jpwright/asp-lfc/README.md

asp-lfc
=======

Schematics and code for my MEng project, a portable light field camera based on angle-sensitive pixel imager.
