jpwright/asp-lfc/MATLAB/poster images/artagain-multi.png

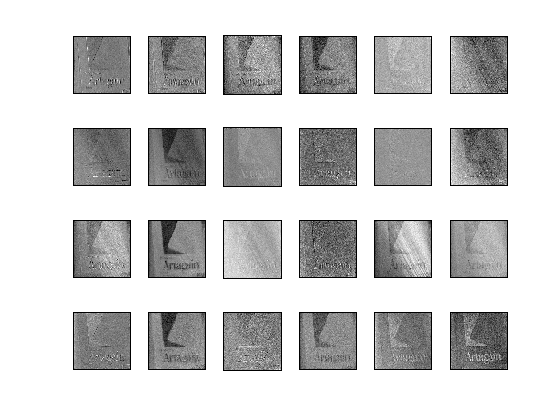
MATLAB/poster images/artagain-multi.png
