jpwright/asp-lfc/MATLAB/poster images/artagain.png

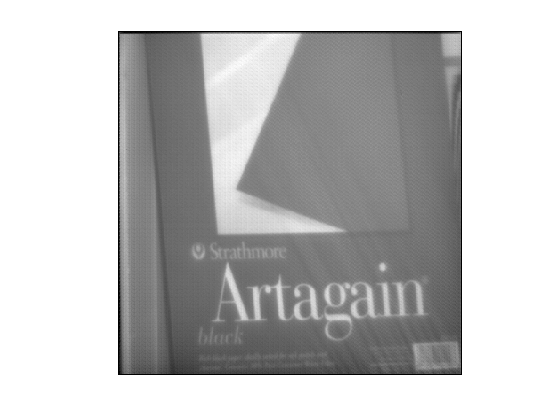
MATLAB/poster images/artagain.png
