jpwright/asp-lfc/MATLAB/poster images/equipment2-multi.png

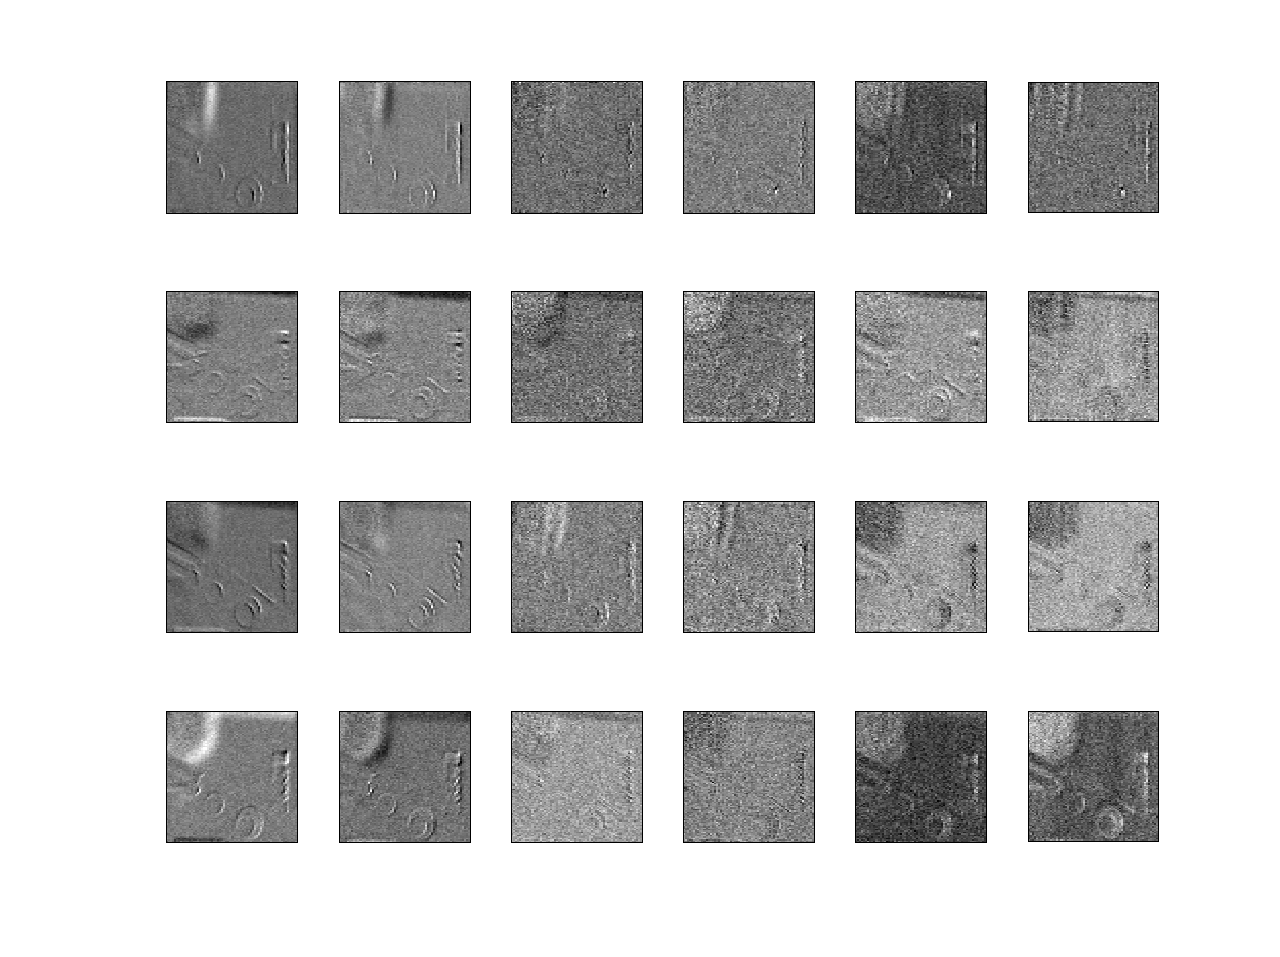
MATLAB/poster images/equipment2-multi.png
