jpwright/asp-lfc/MATLAB/poster images/equipment2.png

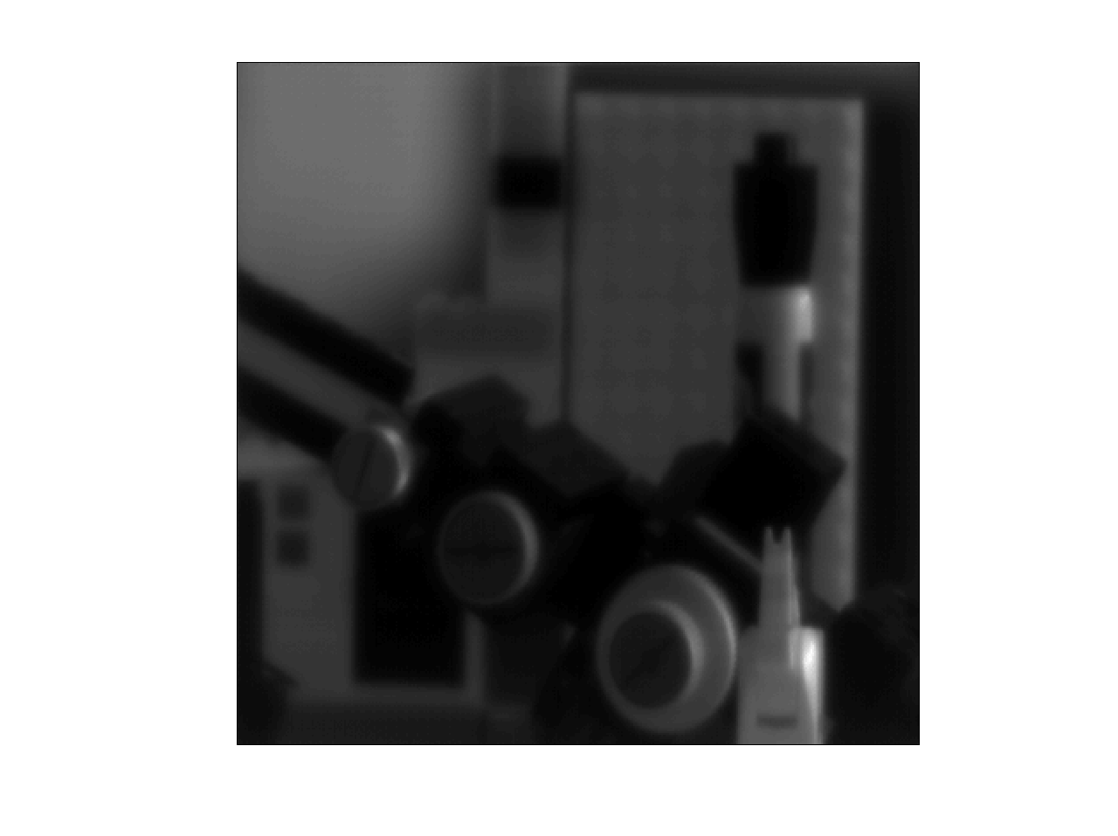
MATLAB/poster images/equipment2.png
