jpwright/asp-lfc/MATLAB/poster images/equipment-multi.png

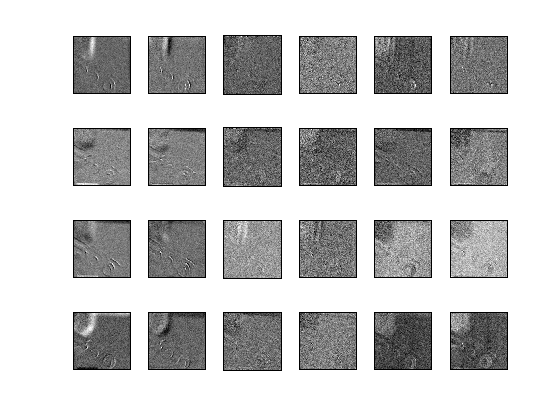
MATLAB/poster images/equipment-multi.png
