jpwright/asp-lfc/MATLAB/poster images/equipment.png

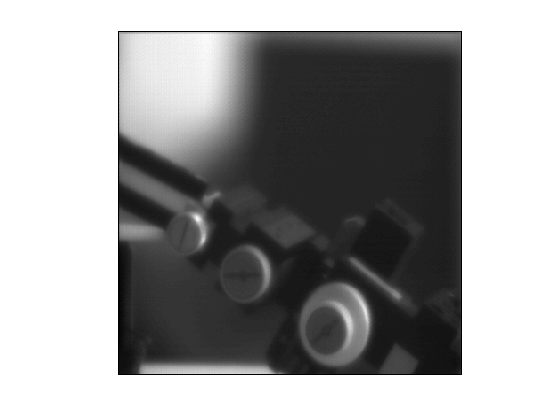
MATLAB/poster images/equipment.png
