jpwright/asp-lfc/MATLAB/poster images/molnar-multi.png

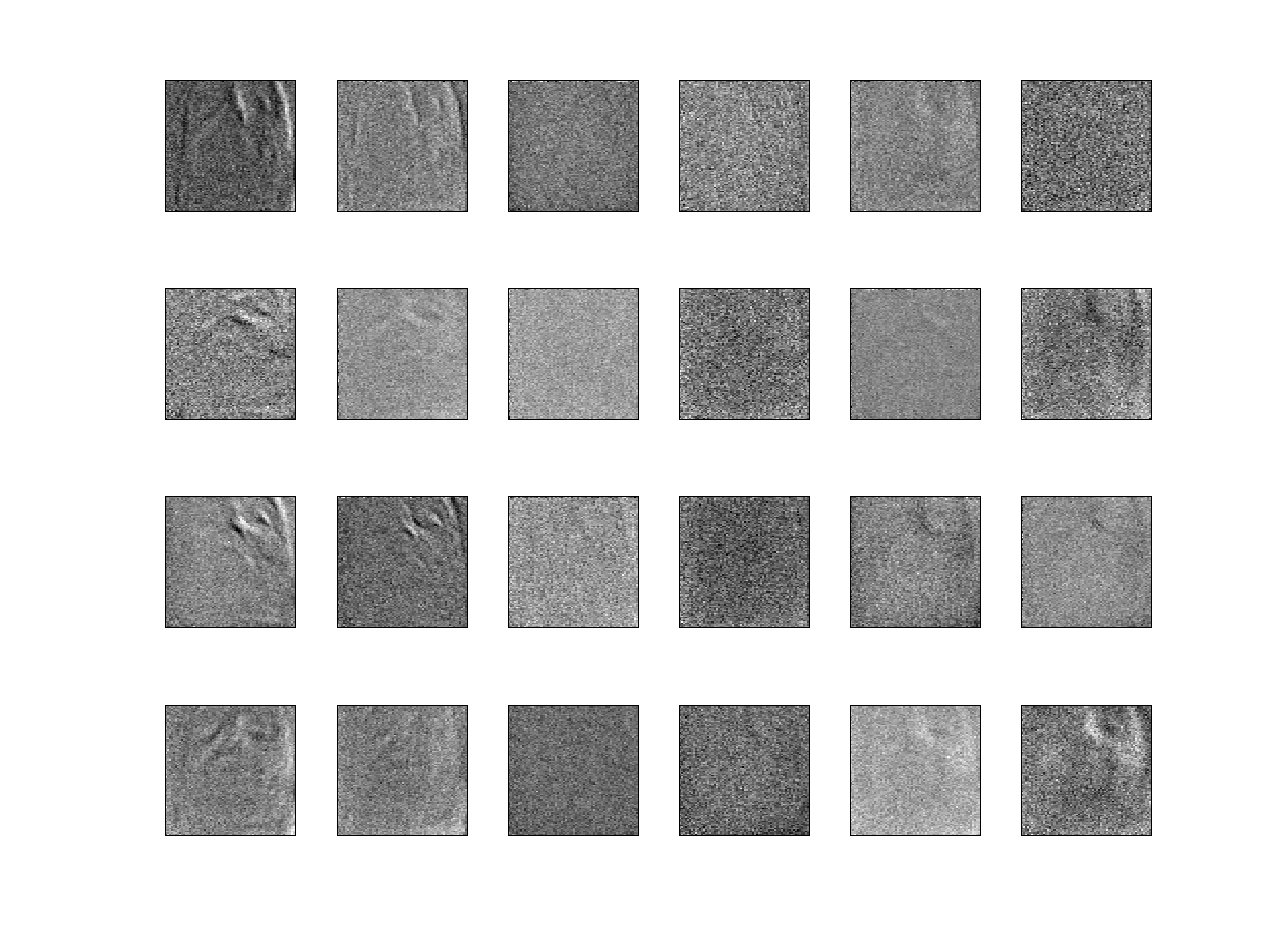
MATLAB/poster images/molnar-multi.png
