jpwright/asp-lfc/MATLAB/poster images/molnar.png

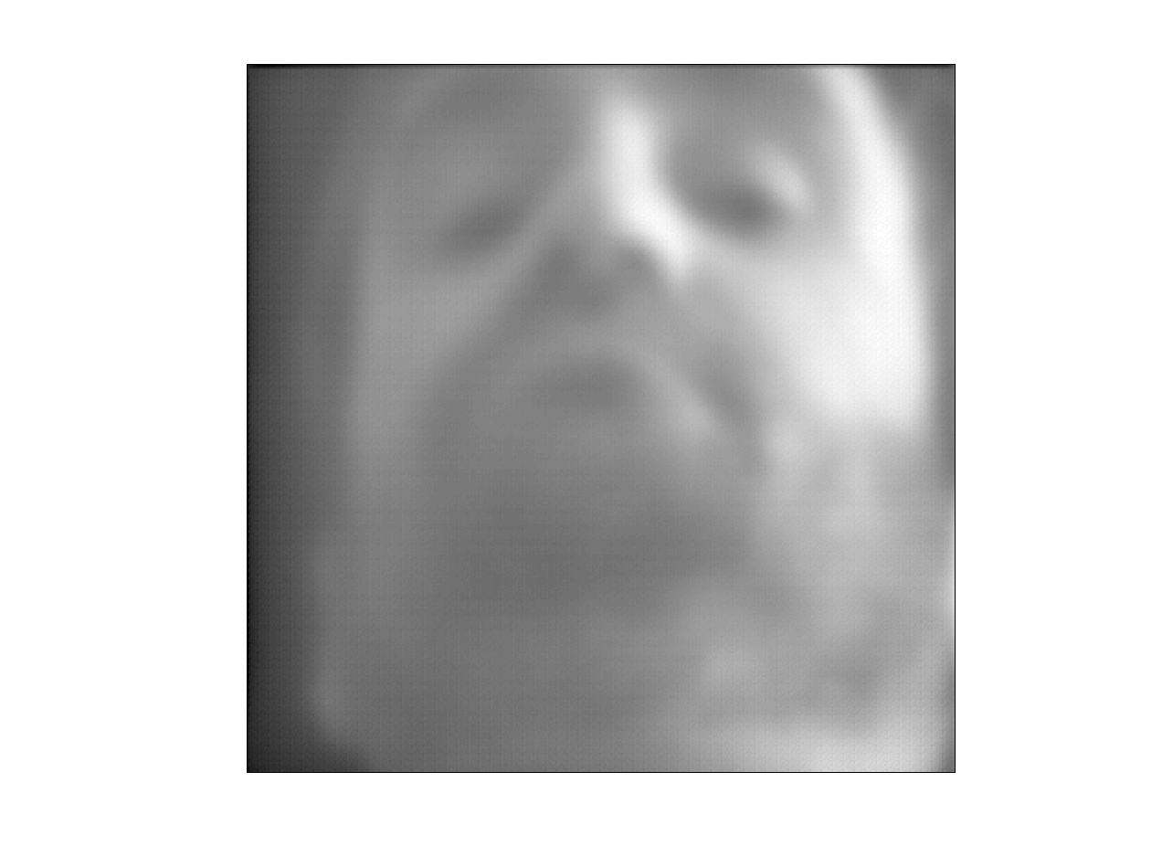
MATLAB/poster images/molnar.png
