jpwright/asp-lfc/PCB/protoCtrl/image-layout.png

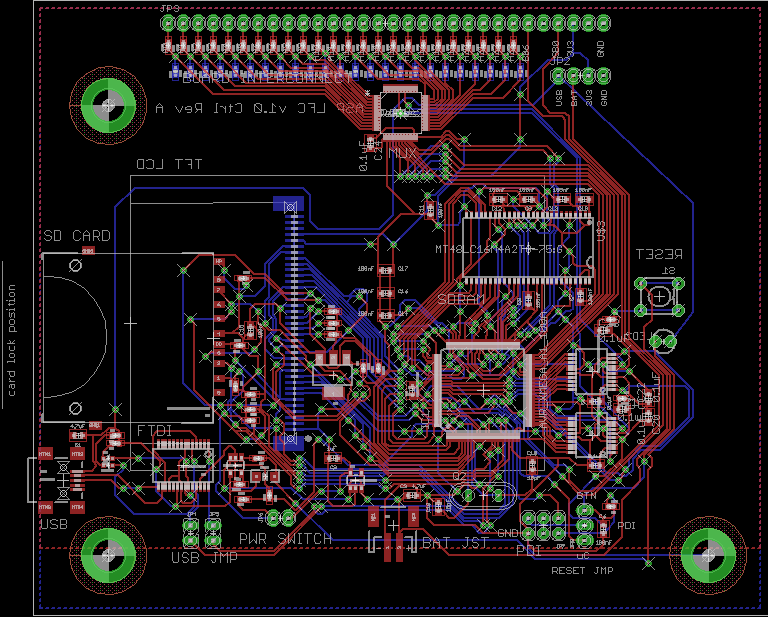
PCB/protoCtrl/image-layout.png
