jpwright/asp-lfc/PCB/protoCtrl/image.png

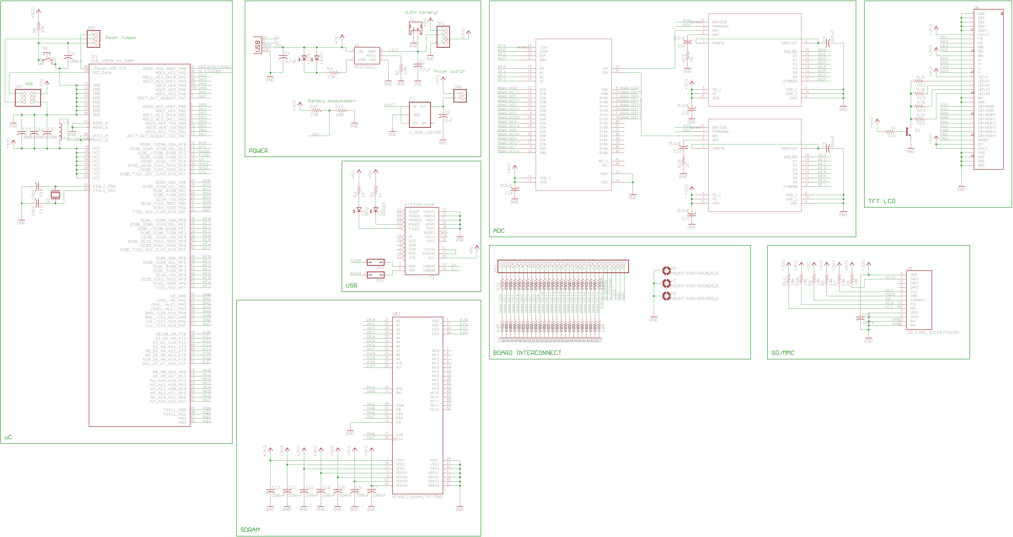
PCB/protoCtrl/image.png
