jpwright/asp-lfc/3D/mount/lensmount2.stl

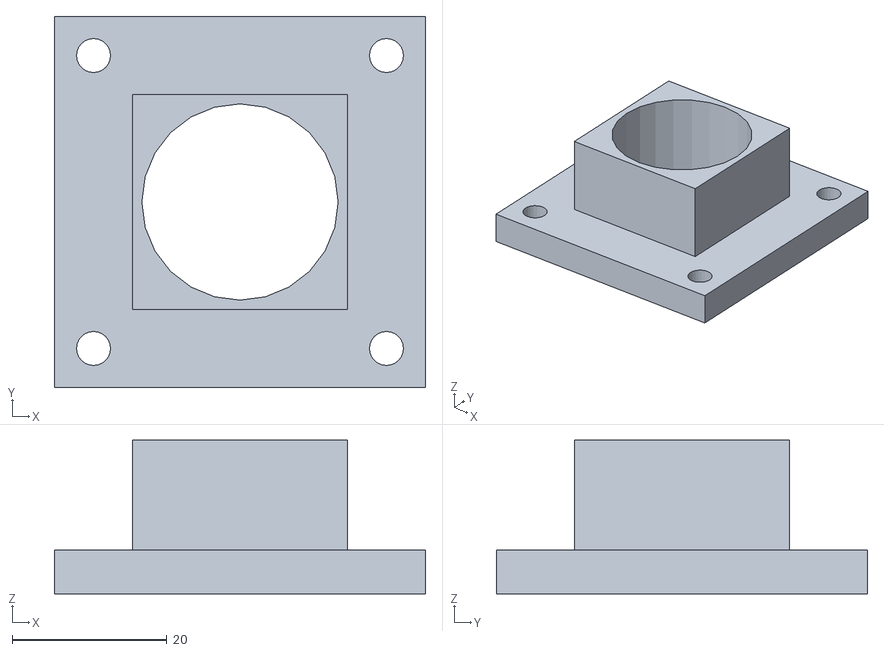
[picture p11: CAD file, 2013-05-15]
3D/mount/lensmount2.stl
48.0 x 48.0 x 19.9
