jpwright/asp-lfc/3D/spacers/v1-outer-dual.stl

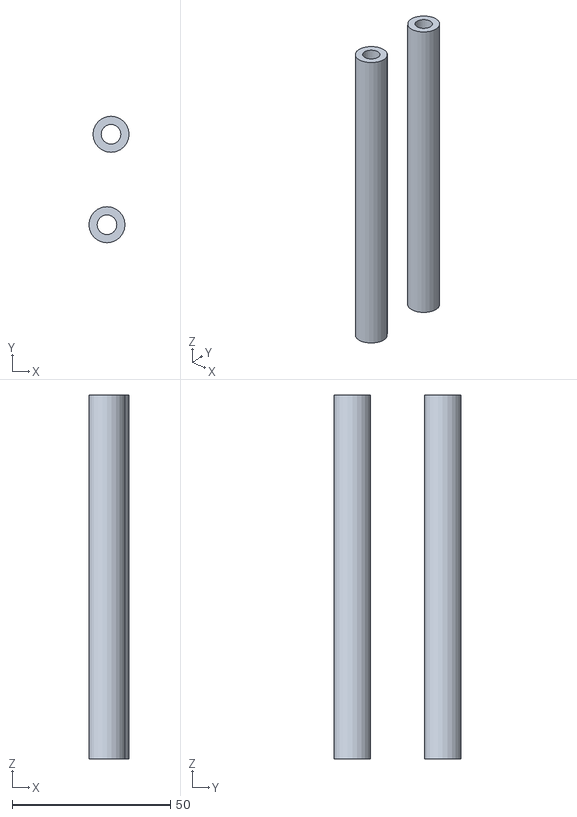
[picture p12: CAD file, 2013-05-15]
3D/spacers/v1-outer-dual.stl
12.7 x 40.0 x 114.9
