jpwright/asp-lfc/3D/mount/lensmount.stl

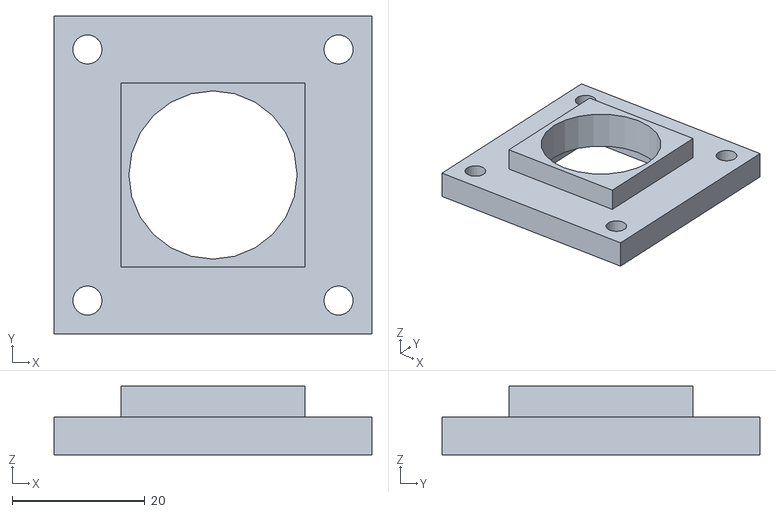
[picture p13: CAD file, 2013-05-15]
3D/mount/lensmount.stl
48.0 x 48.0 x 10.4
