jpwright/asp-lfc/3D/spacers/v1-outer.stl

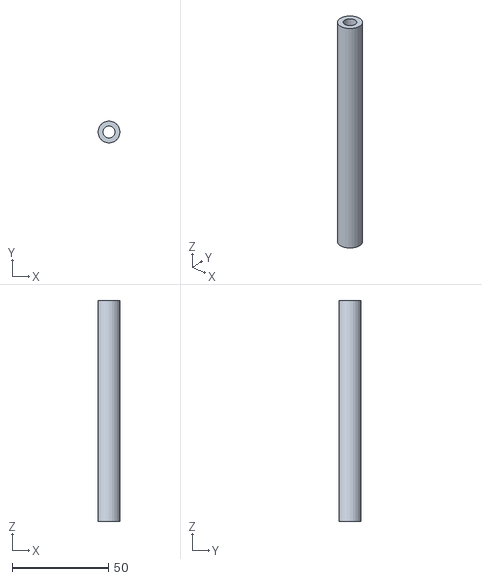
[picture p14: CAD file, 2013-05-15]
3D/spacers/v1-outer.stl
11.4 x 11.4 x 114.9
