jpwright/asp-lfc/3D/spacers/v1.stl

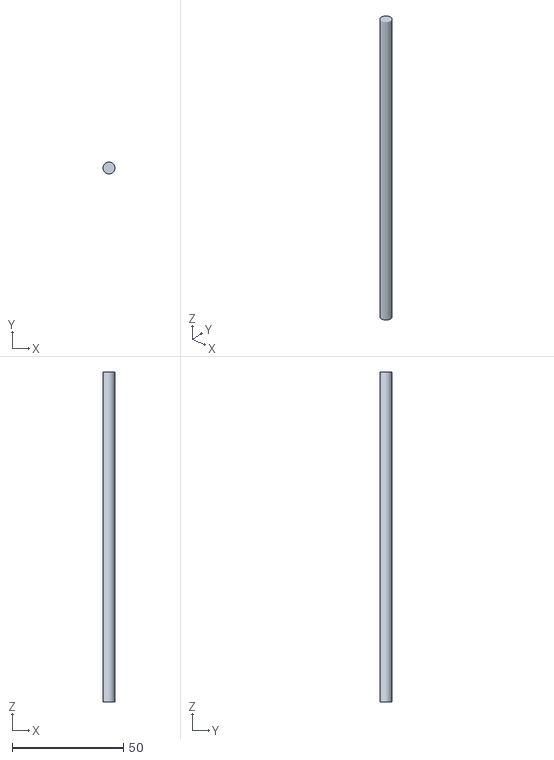
[picture p15: CAD file, 2013-05-15]
3D/spacers/v1.stl
5.40 x 5.40 x 148.6
