jpwright/asp-lfc/3D/spacers/v1-all-dual.stl

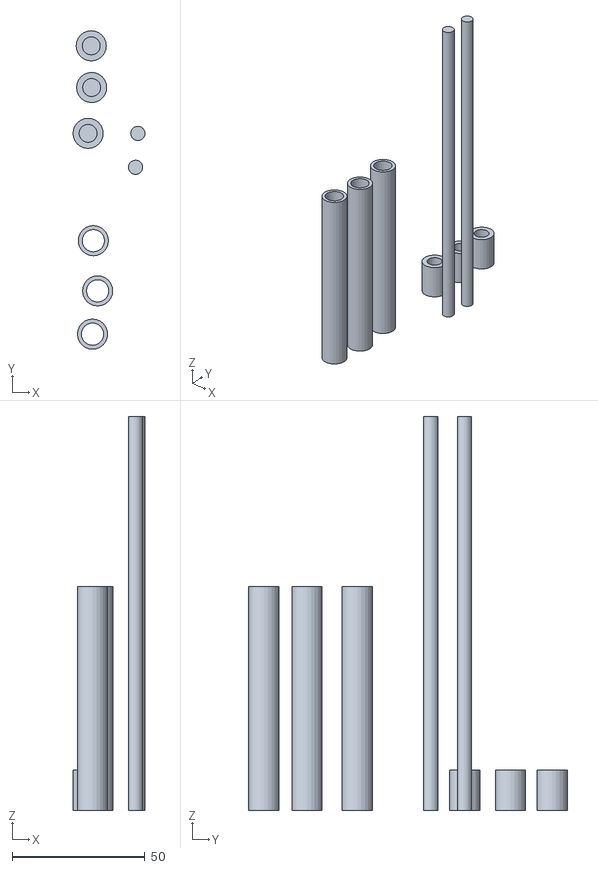
[picture p16: CAD file, 2013-05-15]
3D/spacers/v1-all-dual.stl
27.2 x 120.1 x 148.6
