jpwright/asp-lfc/3D/spacers/v1-dual.stl

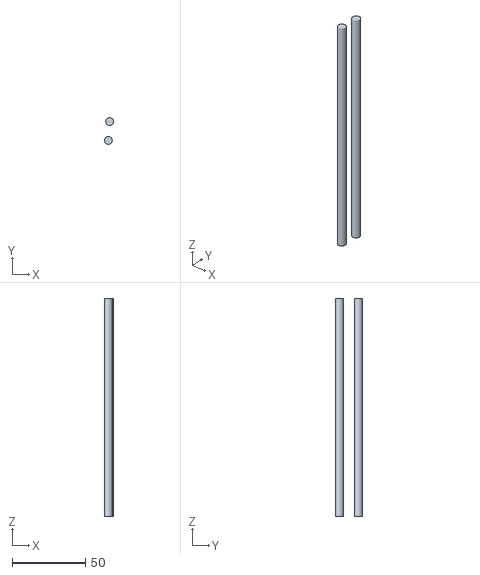
[picture p17: CAD file, 2013-05-15]
3D/spacers/v1-dual.stl
6.26 x 18.2 x 148.6
