jpwright/asp-lfc/3D/spacers/v1-cap.stl

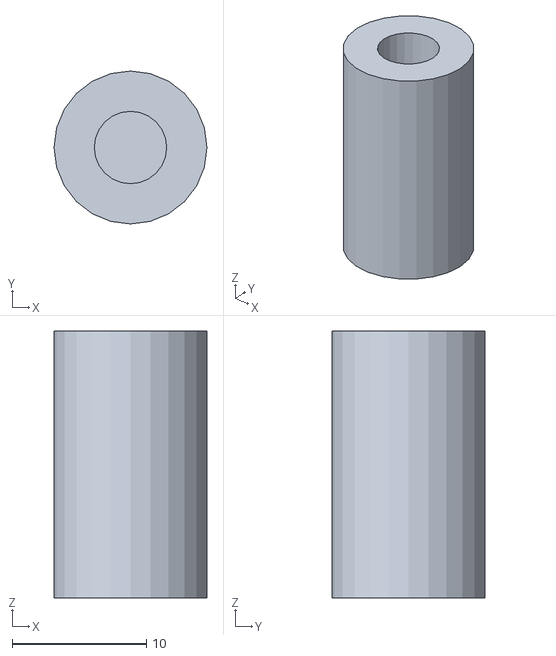
[picture p18: CAD file, 2013-05-15]
3D/spacers/v1-cap.stl
11.4 x 11.4 x 19.9
