jpwright/asp-lfc/(list of files, cad)

Other CAD files:
3D/mount/lensmount.skp
3D/spacers/v1-cap.skp
3D/spacers/v1-dual.skp
3D/spacers/v1-outer-dual.skp
3D/spacers/v1-outer.skp
3D/spacers/v1.skp
