jpwright/asp-lfc/PCB/clocky/clocky.brd

## EAGLE design PCB/clocky/clocky.brd (2013-05-15)

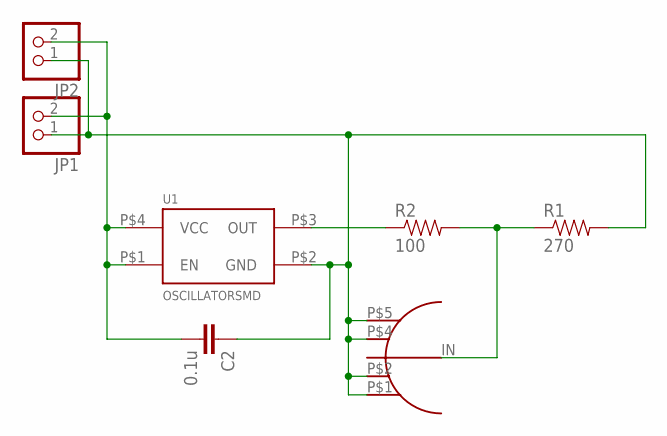
[picture p19: schematic clocky.sch]

Parts:
C2: 0.1u; 0603-CAP
JP1: PINHD-1X2/90; 1X02/90
JP2: PINHD-1X2; 1X02
R1: 270; 0603-RES
R2: 100; 0603-RES
U1: OSCILLATORSMD; CRYSTAL-SMD-7X5
U$1: J658; SMA_J658

Connections:
3V3: C2.2, JP1.2, JP2.2, U1.P$1 (EN), U1.P$4 (VCC)
GND: C2.1, JP1.1, JP2.1, R1.2, U1.P$2 (GND), U$1.P$1 (GNDA), U$1.P$2 (GNDB), U$1.P$4 (GNDC), U$1.P$5 (GNDD)
unnamed: R2.1, U1.P$3 (OUT)
unnamed: R1.1, R2.2, U$1.IN

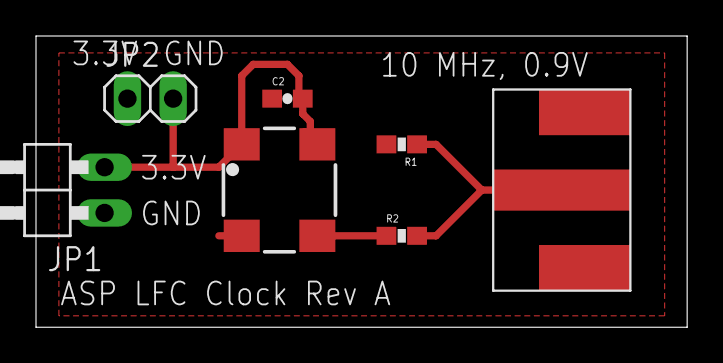
[picture p20: board clocky.brd from above]

Board: 2 copper layers, 36.2 x 16.2 mm, 7 parts (0 on the bottom side), 4 nets.
