jpwright/asp-lfc/PCB/protoBot/protoBot.brd

## EAGLE design PCB/protoBot/protoBot.brd (continued)

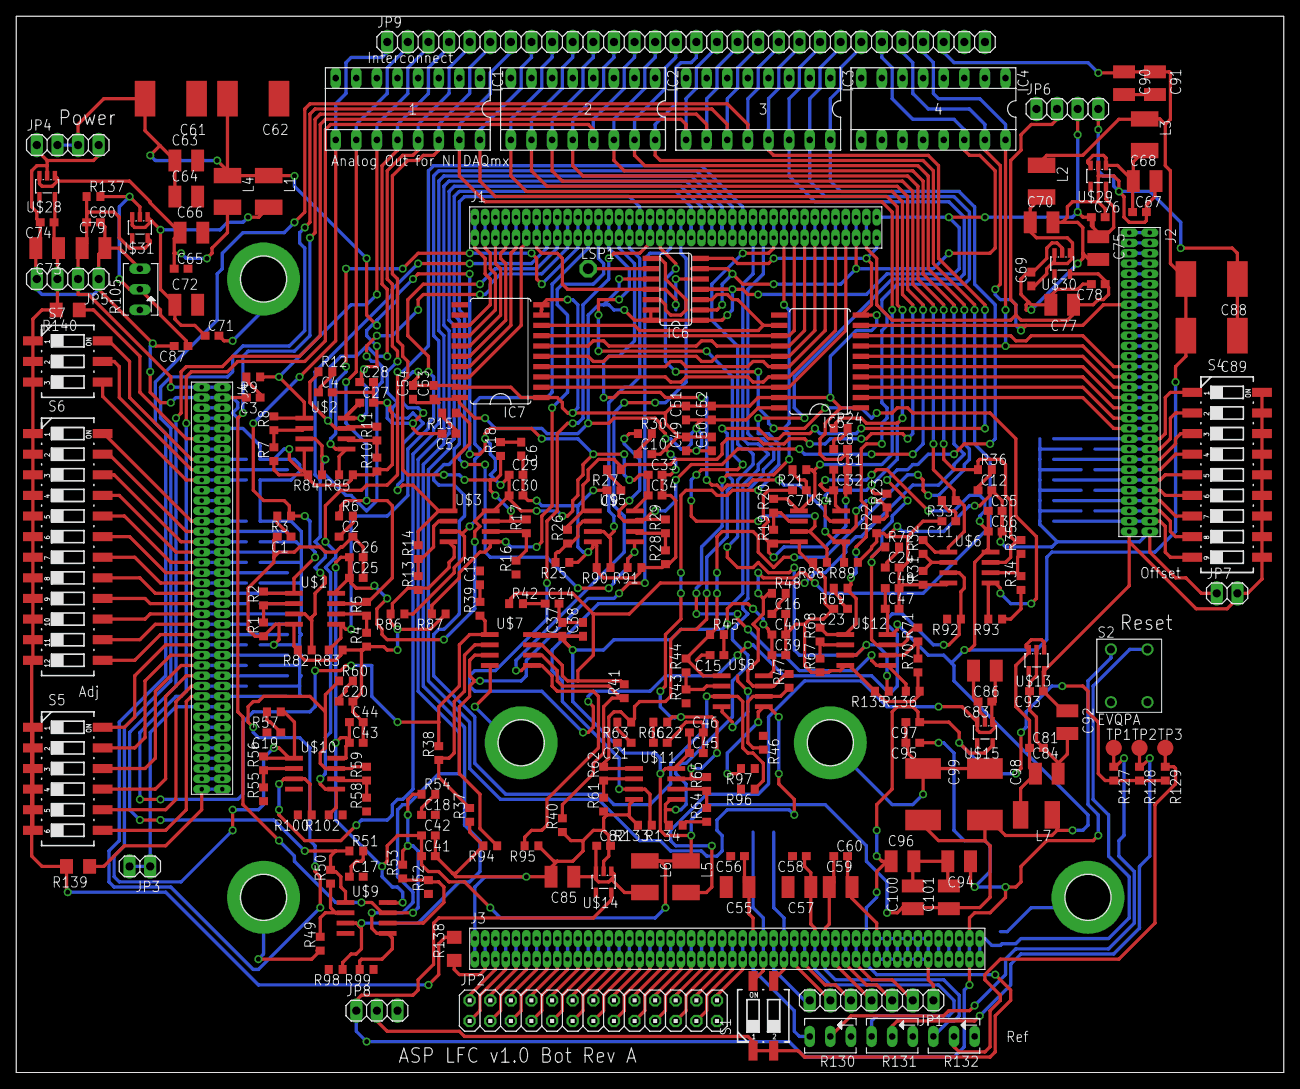
[picture p26: board protoBot.brd from above]

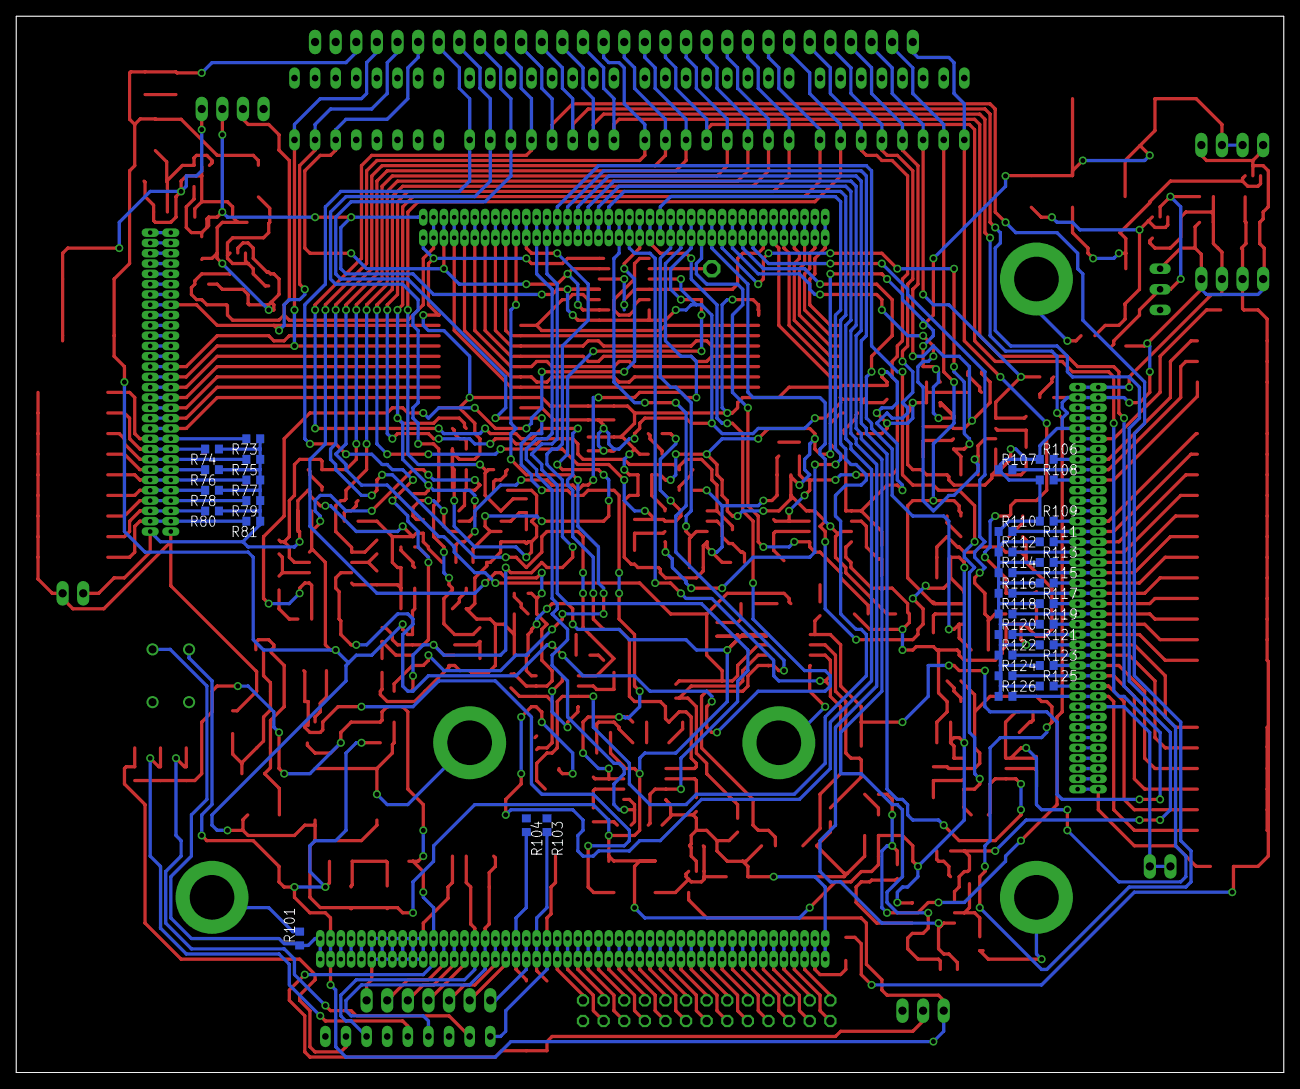
[picture p27: board protoBot.brd from below]

Board: 2 copper layers, 156.2 x 130.2 mm, 302 parts (33 on the bottom side), 239 nets.
