jpwright/asp-lfc/NI/configReport.txt

Date:  10/31/2012 1:05:15 PM
User:  ss2462
File:  C:\Documents and Settings\TEMP\My Documents\configData.nce
MAX version:  5.0

Exporting...
========
NI-VISA 5.0:
  General Settings
  VISA Alias (COM1)
  VISA Alias (COM3)
  VISA Alias (LPT1)
  Port Settings
  Port Settings
  Port Settings
  Aliases
  VISA Server
  Security

NI-DAQmx 9.4:
  AnalogIn4
  AnalogIn4/Voltage_0
  AnalogIn4/Voltage_1
  AnalogIn4/Voltage_2
  AnalogIn4/Voltage_3
  AnalogIn4/Voltage_4
  AnalogIn4/Voltage_5
  AnalogIn4/Voltage_6
  AnalogIn4/Voltage_7
  AnalogIn4/Voltage_8
  AnalogIn4/Voltage_9
  AnalogIn4/Voltage_10
  NI USB-6251 "Dev3"
  DigitalBit
  DigitalBit/DigitalOut
  NI USB-6259 "Dev2"
  Stacked_Amp_Outs_6251a
  Stacked_Amp_Outs_6251a/VoltageOut_0
  Stacked_Amp_Outs_6251a/VoltageOut_1
  Analog012
  Analog012/VoltageOut_0
  3: NI PXIe-6368 "PXI2Slot3"
  SCB-68: "SCB-68/PXI2Slot3/0"
  SCB-68: "SCB-68/PXI2Slot3/1"
  NI PCIe-6537 "Dev1"
  MyDigitalInTask
  MyDigitalInTask/DigitalIn_0
  MyDigitalInTask/DigitalIn_1
  MyDigitalInTask/DigitalIn_2
  MyDigitalInTask/DigitalIn_3
  MyDigitalInTask/DigitalIn_4
  MyDigitalInTask/DigitalIn_5
  SS_AI1
  SS_AI1/Voltage
  MyVoltageOutTask
  MyVoltageOutTask/VoltageOut
  MyVoltageOutTask/VoltageOut_0
  Port1
  Port1/DigitalOut
  port0line4
  AI1
  AI1/Voltage
  A0_test
  A0_test/VoltageOut
  27AnalogIn
  27AnalogIn/Voltage_0
  27AnalogIn/Voltage_1
  27AnalogIn/Voltage_2
  27AnalogIn/Voltage_3
  27AnalogIn/Voltage_4
  27AnalogIn/Voltage_5
  27AnalogIn/Voltage_6
  27AnalogIn/Voltage_7
  27AnalogIn/Voltage_8
  27AnalogIn/Voltage_9
  27AnalogIn/Voltage_10
  27AnalogIn/Voltage_11
  27AnalogIn/Voltage_12
  27AnalogIn/Voltage_13
  27AnalogIn/Voltage_14
  27AnalogIn/Voltage_15
  27AnalogIn/Voltage_16
  27AnalogIn/Voltage_17
  27AnalogIn/Voltage_18
  27AnalogIn/Voltage_19
  27AnalogIn/Voltage_20
  27AnalogIn/Voltage_21
  27AnalogIn/Voltage_22
  27AnalogIn/Voltage_23
  27AnalogIn/Voltage_24
  27AnalogIn/Voltage_25
  27AnalogIn/Voltage_26
  2: NI PXIe-6368 "PXI2Slot2"
  SCB-68: "SCB-68/PXI2Slot2/1"
  4DiffIn
  4DiffIn/Voltage_0
  Port0
  Port0/DigitalOut
  Analog0and1
  Analog0and1/VoltageOut_0
  Analog0and1/VoltageOut_1
  Counter1
  Counter1/PulseOutput
  SS_P0L1
  SS_P0L1/DigitalOut
  sineout
  sineout/VoltageOut
  MyVoltageOutTask_2
  MyVoltageOutTask_2/VoltageOut
  DigitalPort0
  DigitalPort0/DigitalOut
  PCIPort1
  PCIPort1/DigitalOut
  1ChannelIN
  1ChannelIN/Voltage
  GenCLK
  GenCLK/PulseOutput
  Digital_Out_P0_0
  Digital_Out_P0_0/DigitalOut
  SS_AO
  SS_AO/VoltageOut
  DAQ Assistant_0
  DAQ Assistant_0/Voltage_0
  6537_Port1_line0
  6537_Port1_line0/DigitalOut
  6537_Port1_line0/DigitalOut_0
  Counter0
  Counter0/PulseOutput
  AllChannelsEver
  AllChannelsEver/Voltage_0
  AllChannelsEver/Voltage_1
  AllChannelsEver/Voltage_2
  AllChannelsEver/Voltage_3
  AllChannelsEver/Voltage_4
  AllChannelsEver/Voltage_5
  AllChannelsEver/Voltage_6
  AllChannelsEver/Voltage_7
  AllChannelsEver/Voltage_8
  AllChannelsEver/Voltage_9
  AllChannelsEver/Voltage_10
  AllChannelsEver/Voltage_11
  AllChannelsEver/Voltage_12
  AllChannelsEver/Voltage_13
  AllChannelsEver/Voltage_14
  AllChannelsEver/Voltage_15
  AllChannelsEver/Voltage_16
  AllChannelsEver/Voltage_17
  AllChannelsEver/Voltage_18
  AllChannelsEver/Voltage_19
  AllChannelsEver/Voltage_20
  AllChannelsEver/Voltage_21
  AllChannelsEver/Voltage_22
  AllChannelsEver/Voltage_23
  AllChannelsEver/Voltage_24
  AllChannelsEver/Voltage_25
  AllChannelsEver/Voltage_26
  AllChannelsEver/Voltage_27
  AllChannelsEver/Voltage_28
  AllChannelsEver/Voltage_29
  AllChannelsEver/Voltage_30
  AllChannelsEver/Voltage_31
  4AnalogOut
  4AnalogOut/VoltageOut_0
  4AnalogOut/VoltageOut_1
  4AnalogOut/VoltageOut_2
  4AnalogOut/VoltageOut_3
  4AnalogIn
  4AnalogIn/Voltage_0
  4AnalogIn/Voltage_1
  4AnalogIn/Voltage_2
  4AnalogIn/Voltage_3
  ScopeTakse
  ScopeTakse/Voltage
  ScopeTakse/Voltage_0
  ScopeTakse/Voltage_1
  4_channel_diff_PXI
  4_channel_diff_PXI/Voltage_0
  4_channel_diff_PXI/Voltage_1
  4_channel_diff_PXI/Voltage_2
  4_channel_diff_PXI/Voltage_3
  MyVoltageOutTask_0
  MyVoltageOutTask_0/VoltageOut
  Analog_0
  Analog_0/VoltageOut
  A0_Olfactory
  A0_Olfactory/VoltageOut
  Stacked_Amp_Outs
  Stacked_Amp_Outs/VoltageOut_0
  Stacked_Amp_Outs/VoltageOut_1
  Stacked_Amp_Outs/VoltageOut_2
  Stacked_Amp_Outs/VoltageOut_3
  MyVoltageOutTask_3
  MyVoltageOutTask_3/VoltageOut_0
  MyVoltageOutTask_3/VoltageOut_1
  SS_P0L0
  SS_P0L0/DigitalOut
  SS_P0L0/DigitalOut_0
  SS_P0
  SS_P0/DigitalOut
  AllChannels
  AllChannels/Voltage_0
  AllChannels/Voltage_1
  AllChannels/Voltage_2
  AllChannels/Voltage_3
  AllChannels/Voltage_4
  AllChannels/Voltage_5
  AllChannels/Voltage_6
  AllChannels/Voltage_7
  AllChannels/Voltage_8
  AllChannels/Voltage_9
  AllChannels/Voltage_10
  AllChannels/Voltage_11
  AllChannels/Voltage_12
  AllChannels/Voltage_13
  AllChannels/Voltage_14
  AllChannels/Voltage_15
  AllChannels/Voltage_16
  AllChannels/Voltage_17
  AllChannels/Voltage_18
  AllChannels/Voltage_19
  AllChannels/Voltage_20
  AllChannels/Voltage_21
  AllChannels/Voltage_22
  AllChannels/Voltage_23
  AllChannels/Voltage_24
  AllChannels/Voltage_25
  AllChannels/Voltage_26
  AllChannels/Voltage_27
  AllChannels/Voltage_28
  AllChannels/Voltage_29
  AllChannels/Voltage_30
  AllChannels/Voltage_31
  4ch_imager_PXI
  4ch_imager_PXI/Voltage_0
  4ch_imager_PXI/Voltage_1
  4ch_imager_PXI/Voltage_2
  4ch_imager_PXI/Voltage_3
  Stacked_Amp_Outs_6259_23
  Stacked_Amp_Outs_6259_23/VoltageOut_0
  Stacked_Amp_Outs_6259_23/VoltageOut_1
  Stacked_Amp_Outs_6259_23/VoltageOut_2
  Stacked_Amp_Outs_6259_23/VoltageOut_3
  AllAIChannels
  AllAIChannels/Voltage_0
  AllAIChannels/Voltage_1
  AllAIChannels/Voltage_2
  AllAIChannels/Voltage_3
  AllAIChannels/Voltage_4
  AllAIChannels/Voltage_5
  AllAIChannels/Voltage_6
  AllAIChannels/Voltage_7
  AllAIChannels/Voltage_8
  AllAIChannels/Voltage_9
  AllAIChannels/Voltage_10
  AllAIChannels/Voltage_11
  AllAIChannels/Voltage_12
  AllAIChannels/Voltage_13
  AllAIChannels/Voltage_14
  AllAIChannels/Voltage_15
  AllAIChannels/Voltage_16
  AllAIChannels/Voltage_17
  AllAIChannels/Voltage_18
  AllAIChannels/Voltage_19
  AllAIChannels/Voltage_20
  AllAIChannels/Voltage_21
  AllAIChannels/Voltage_22
  AllAIChannels/Voltage_23
  AllAIChannels/Voltage_24
  AllAIChannels/Voltage_25
  AllAIChannels/Voltage_26
  AllAIChannels/Voltage_27
  AllAIChannels/Voltage_28
  AllAIChannels/Voltage_29
  AllAIChannels/Voltage_30
  AllAIChannels/Voltage_31
  Voltage_Out_2ch
  Voltage_Out_2ch/VoltageOut_0
  Voltage_Out_2ch/VoltageOut_1
  Stacked_Amp_Outs2
  Stacked_Amp_Outs2/VoltageOut_0
  Stacked_Amp_Outs2/VoltageOut_1
  Stacked_Amp_Outs2/VoltageOut_2
  Stacked_Amp_Outs2/VoltageOut_3
  CTR0
  PCIP0L0
  PCIP0L0/DigitalOut
  2_Ao
  2_Ao/VoltageOut_0
  2_Ao/VoltageOut_1
  Port1Line1_2
  Port1Line1_2/DigitalOut_0
  Port1Line1_2/DigitalOut_1
  Stacked_Amp_Outs_6269_01
  Stacked_Amp_Outs_6269_01/VoltageOut_0
  Stacked_Amp_Outs_6269_01/VoltageOut_1
  USB_Digital_Port_IN
  USB_Digital_Port_IN/DigitalIn
  AI0
  AI0/Voltage
  MyVoltageOutTask_1
  MyVoltageOutTask_1/VoltageOut_0
  2_Analog_Outs
  2_Analog_Outs/VoltageOut_0
  2_Analog_Outs/VoltageOut_1
  Port1Line0_1
  Port1Line0_1/DigitalOut_0
  Port1Line0_1/DigitalOut_1
  myAI0
  myAI0/Voltage
  MyDigitalOutTask
  MyDigitalOutTask/DigitalOut
  LukesTaskThatWorks
  LukesTaskThatWorks/Voltage_0
  LukesTaskThatWorks/Voltage_1
  LukesTaskThatWorks/Voltage_2
  LukesTaskThatWorks/Voltage_3
  DAQ Assistant_1
  DAQ Assistant_1/DigitalIn
  USB_Digital_IN
  USB_Digital_IN/DigitalIn
  Rampgen
  Rampgen/VoltageOut
  MyVoltageOutTask_4
  MyVoltageOutTask_4/VoltageOut
  2: NI PXIe-6548 "PXI1Slot2"
  6537_Port1_line1
  6537_Port1_line1/DigitalOut
  DigIn1
  DigIn1/DigitalIn
  Single_Channel_6259
  Single_Channel_6259/Voltage
  port0line2

*** Export complete ***
