jpwright/asp-lfc/(commit log)

2013-05-15 PCB commit
    [bom.csv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]
2013-05-15 3D commit
    [lensmount.skp, lensmount.stl, lensmount2.stl, v1-all-dual.stl, v1-cap.skp, v1-cap.stl, v1-dual.skp, v1-dual.stl]
2013-05-15 NI commit
    [configReport.txt]
2013-05-15 added ADC calculation script
2013-05-17 updated SDRAM.c to include steps to recreate issue
    [SDRAM.c]
2013-06-01 adding images and cleaning up
    [protoCtrl.sch]
